evanlong/etching/README.md

## Overview

This project demonstrates how to build a simple automated Etch-a-Sketch. It produces images that look something like this:

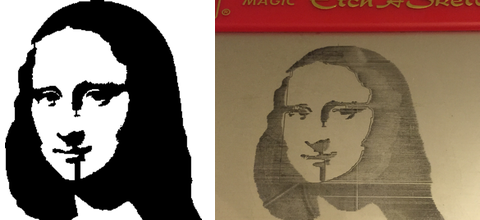
[picture p1: Schematics/Images/ResultMona.png]
Knob Removal


Instructions on how to build and use the device can be found [here](EtchingStepByStep.md) and at my [website](http://www.evanlong.info/projects/etching/).
