evanlong/etching/arduino/SketchTheEtch/About/README.txt

	embedXcode
	----------------------------------
	Embedded Computing Template on Xcode 4

	© Rei VILO, 2010-2012
	CC = BY NC SA

	• Documentation
	http://embedXcode.weebly.com/

	• Installation package
	http://embedXcode.weebly.com/download
	
	• GitHub repository
	https://github.com/rei-vilo/embedXcode

embedXcode • Sep 25, 2012 release 16 • Support for FraunchPad
Installation Guide • Sep 25, 2012 release 13 • Support for FraunchPad

Installation
----------------------------------
Launch the embedXcode package.
Read enclosed Installation Guide.

Contributions
----------------------------------
See attached documents for detailed references

----------------------------------
End of file
