evanlong/etching/SampleAssets/200x200.png

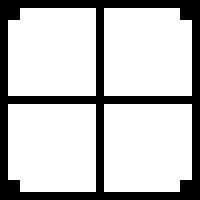
SampleAssets/200x200.png
