evanlong/etching/SampleAssets/500x320.png

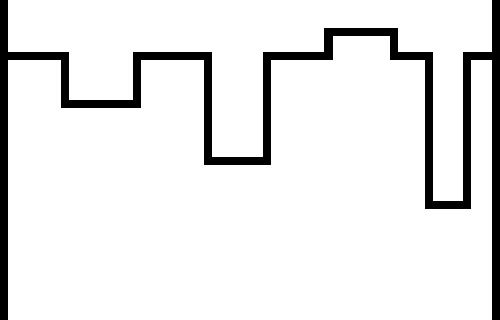
SampleAssets/500x320.png
