evanlong/etching/SampleAssets/mona.png

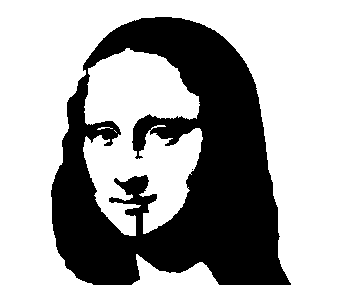
SampleAssets/mona.png
