evanlong/etching/Schematics/Images/2014-02-14 23.08.20.jpg

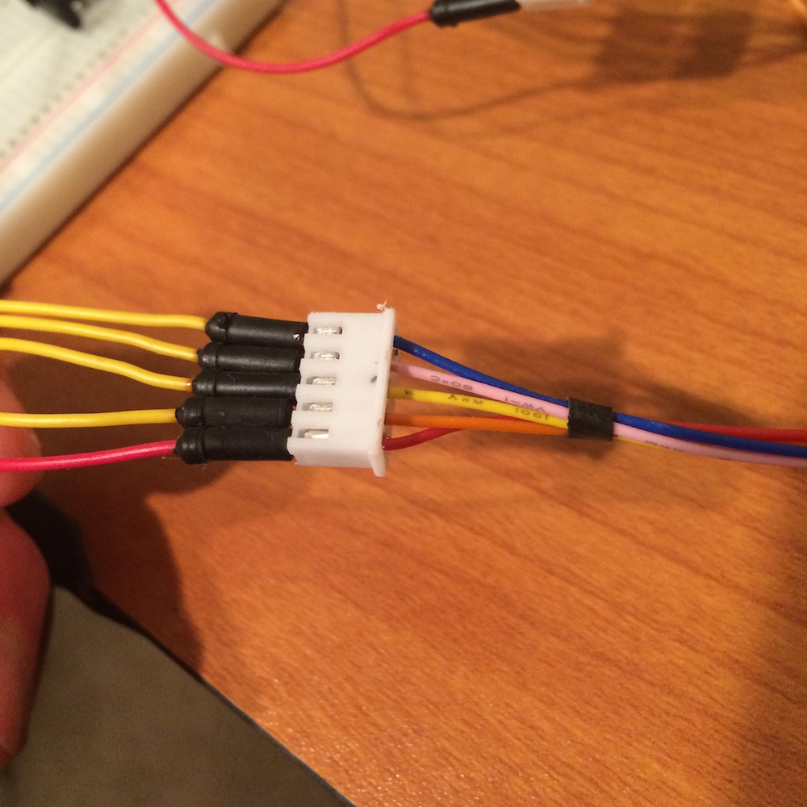
Schematics/Images/2014-02-14 23.08.20.jpg
