evanlong/etching/Schematics/Images/2014-02-14 23.12.30.jpg

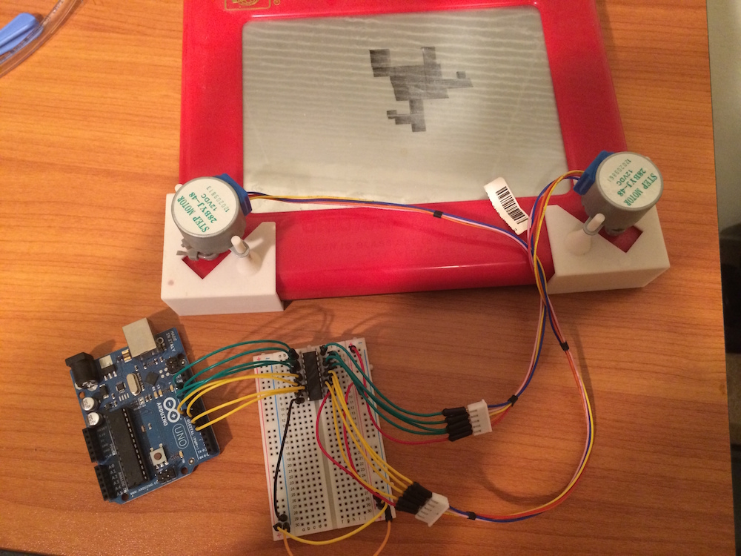
Schematics/Images/2014-02-14 23.12.30.jpg
