evanlong/etching/Schematics/Images/wiredup.JPG

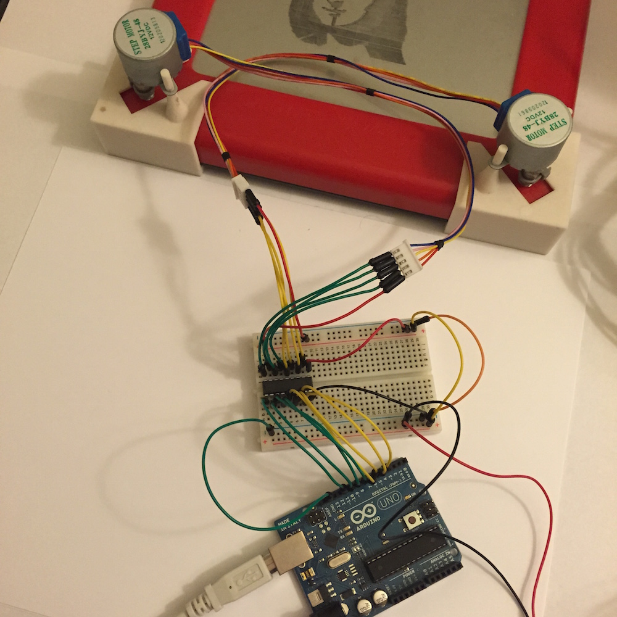
Schematics/Images/wiredup.JPG
