evanlong/etching/Schematics/layout_bread_board.png

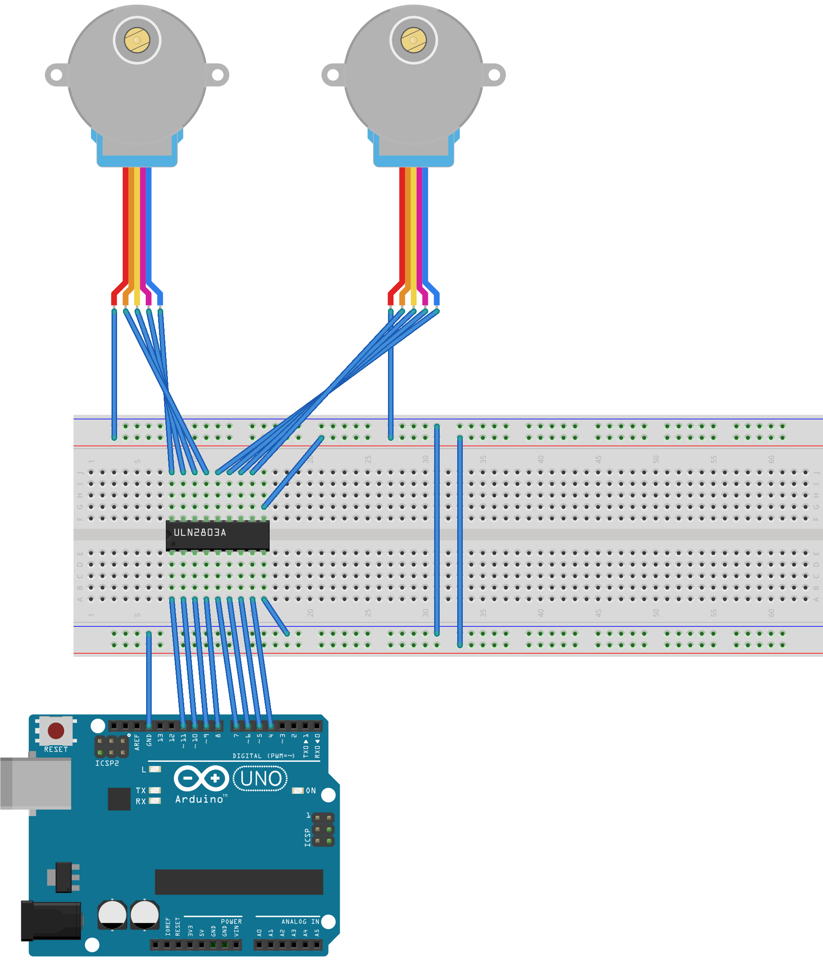
Schematics/layout_bread_board.png
