evanlong/etching/Schematics/layout_schematic.png

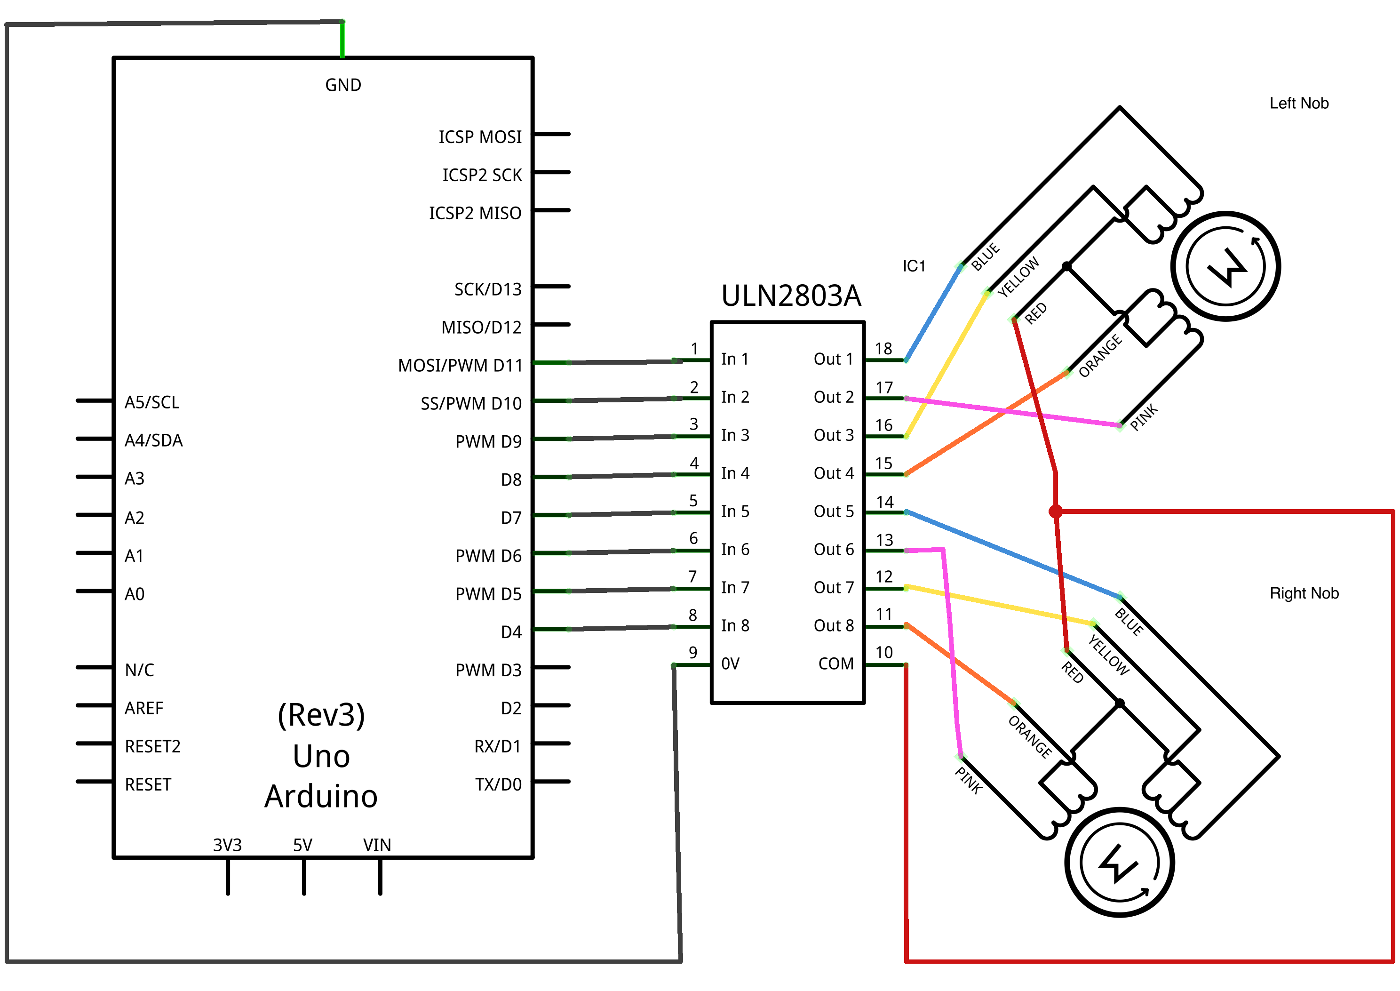
Schematics/layout_schematic.png
