evanlong/etching/(list of files, drawings)

Other design files:
Schematics/layout.fzz
