evanlong/etching/(commit log)

2012-11-14 Ability to drive motors on a particular vector nice and smooth.
2012-11-18 iPad => Webserver => arduino
2012-11-19 arduino signals when it is done drawing a vector
2013-11-17 Adding schematic drawings
    [layout.fzz]
2013-11-17 Adding 3D model of motor mount
2014-02-15 Moving bunches of files arond
    [layout.fzz]
2014-12-17 Add images for documentation and sample assets.
